Phenomenal46/Automated-Surveillance-System/docs/esp32 cam back.jpg

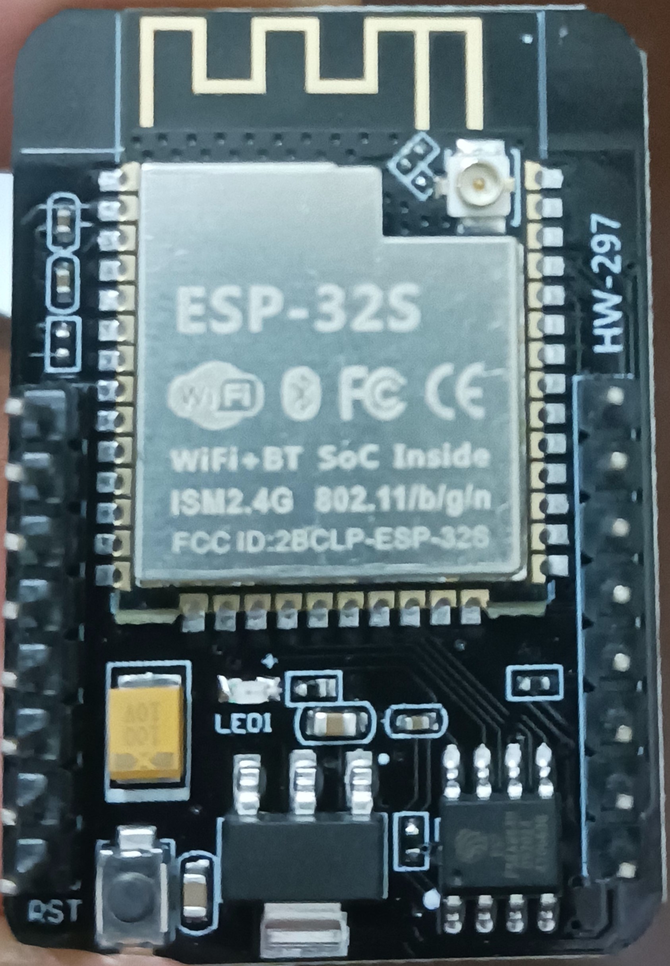
docs/esp32 cam back.jpg
