Phenomenal46/Automated-Surveillance-System/docs/esp32 cam front.jpg

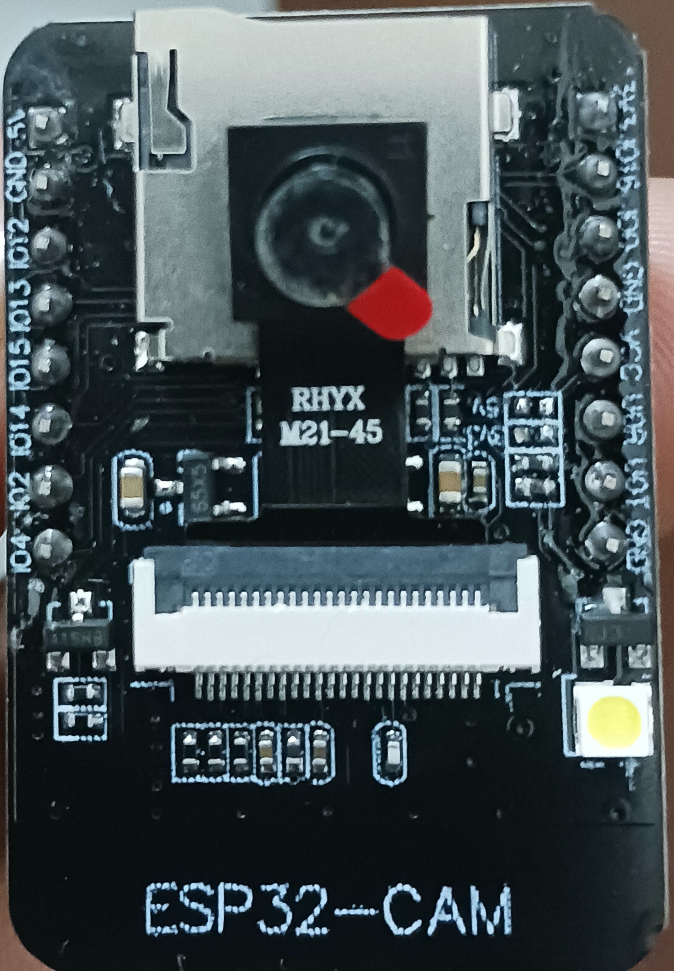
docs/esp32 cam front.jpg
