Phenomenal46/Automated-Surveillance-System/(commit log)

2025-12-05 Initial commit: Automated surveillance system with Arduino and ESP32-CAM
2025-12-11 Update README with ESP32 CAM firmware flashing details
    Clarified the description of the ESP32 CAM issue during firmware flashing.
